MichalKot89/planar-parallel-redundant-manipulator/latex/grafika/pierwowzor_model.pdf

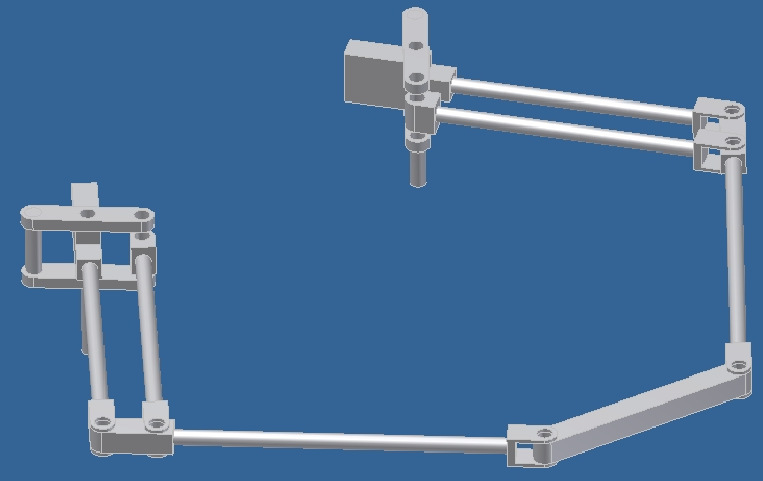
[picture p2: page 1]
