MichalKot89/planar-parallel-redundant-manipulator/latex/grafika/pierwowzor_zdjecie.pdf

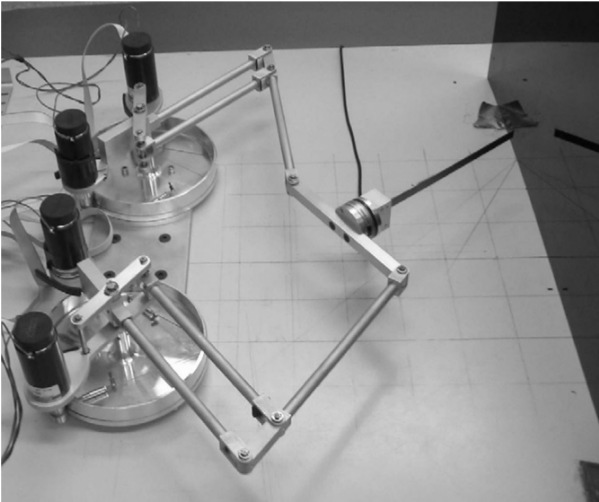
[picture p3: page 1]
