MichalKot89/planar-parallel-redundant-manipulator/Przestrzen robocza probna/Matlab/Forward/L=0.pdf

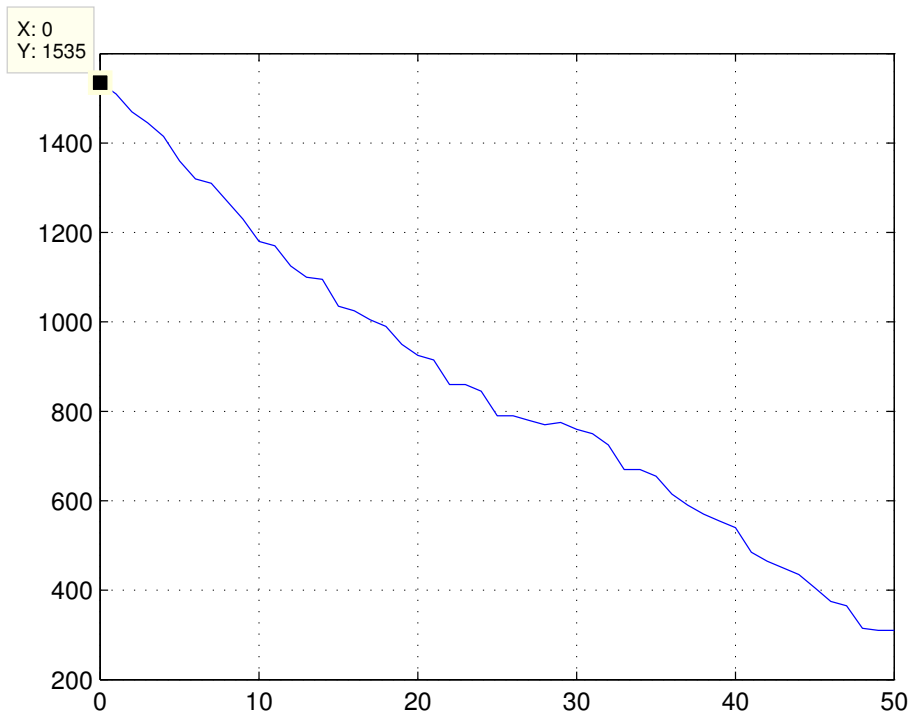
[picture p4: figure]
