MichalKot89/planar-parallel-redundant-manipulator/Przestrzen robocza probna/Matlab/Forward/L=10.pdf

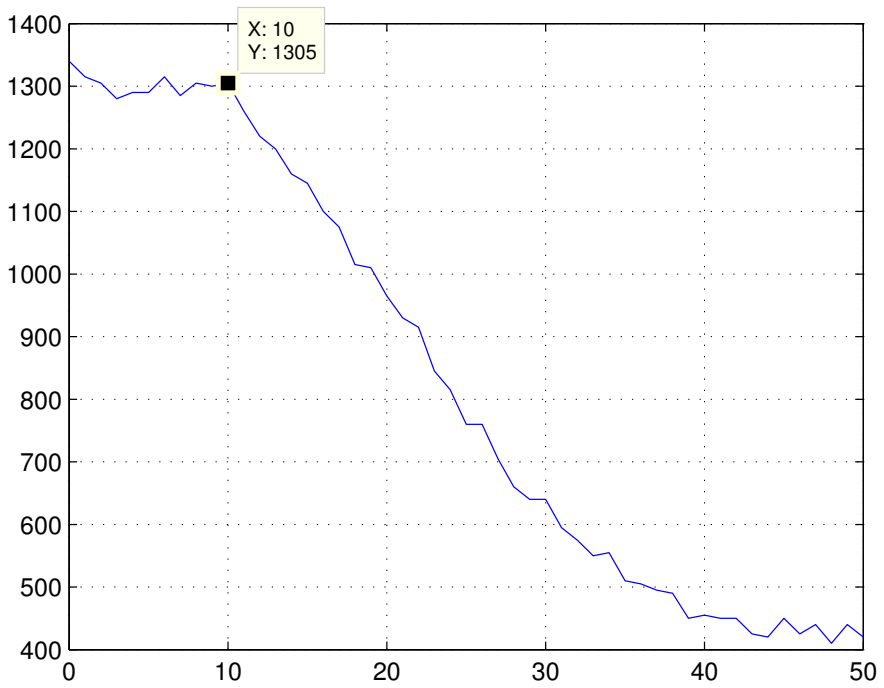
[picture p5: figure]
