MichalKot89/planar-parallel-redundant-manipulator/Przestrzen robocza probna/Matlab/Forward/L=20.pdf

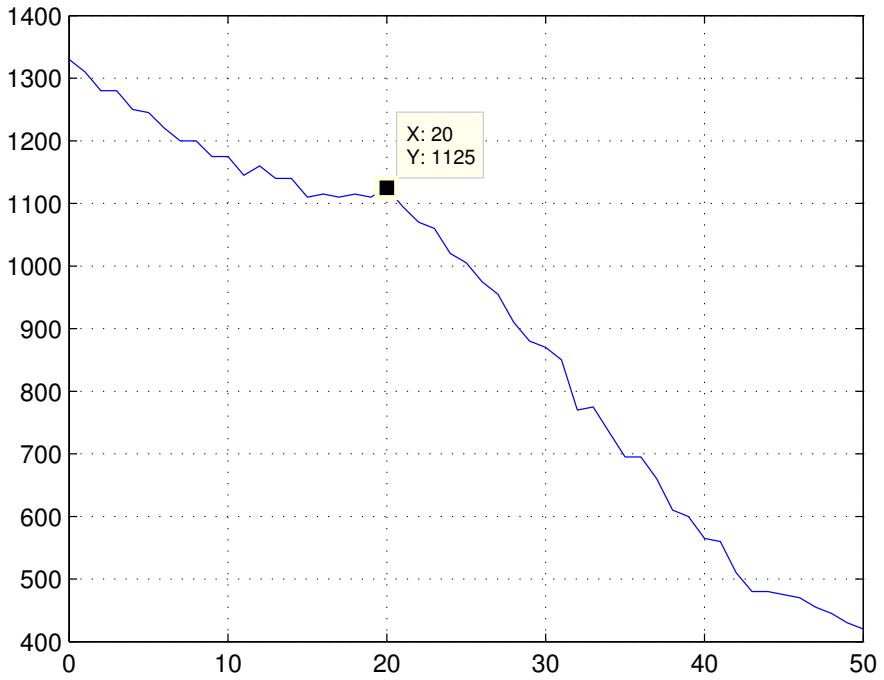
[picture p6: figure]
