MichalKot89/planar-parallel-redundant-manipulator/Przestrzen robocza probna/Matlab/Forward/L=30.pdf

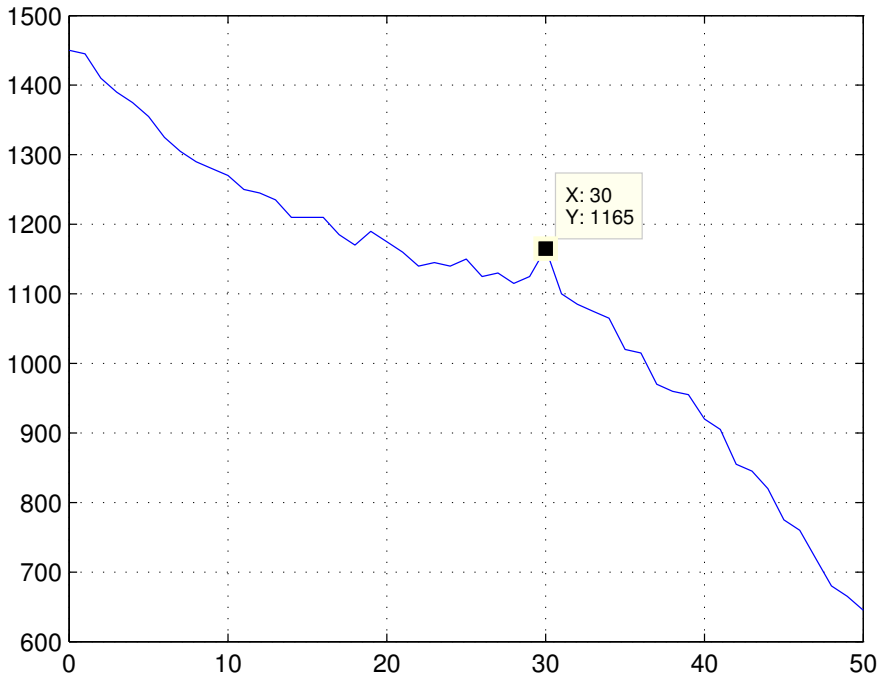
[picture p7: figure]
