MichalKot89/planar-parallel-redundant-manipulator/Przestrzen robocza probna/Matlab/Inverse/L=0_inv.pdf

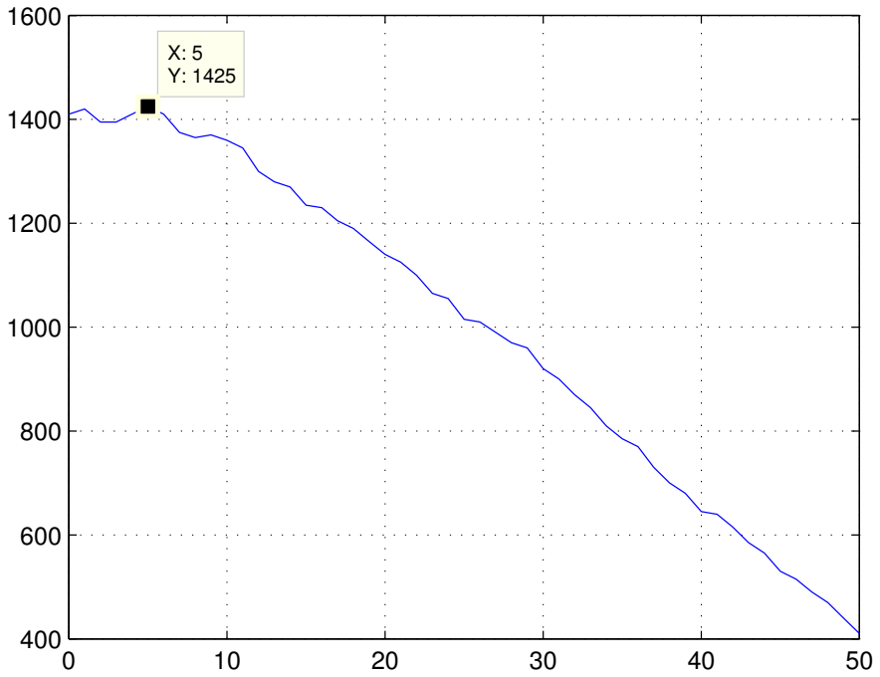
[picture p8: figure]
