MichalKot89/planar-parallel-redundant-manipulator/Przestrzen robocza probna/Matlab/Inverse/L=10_inv.pdf

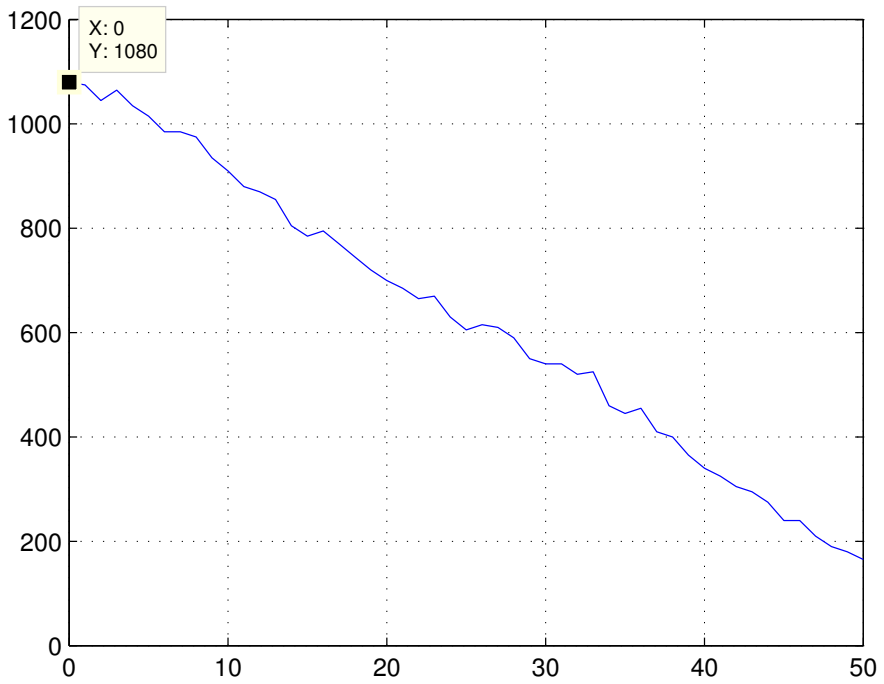
[picture p9: figure]
