MichalKot89/planar-parallel-redundant-manipulator/Przestrzen robocza probna/Matlab/Inverse/L=20_inv.pdf

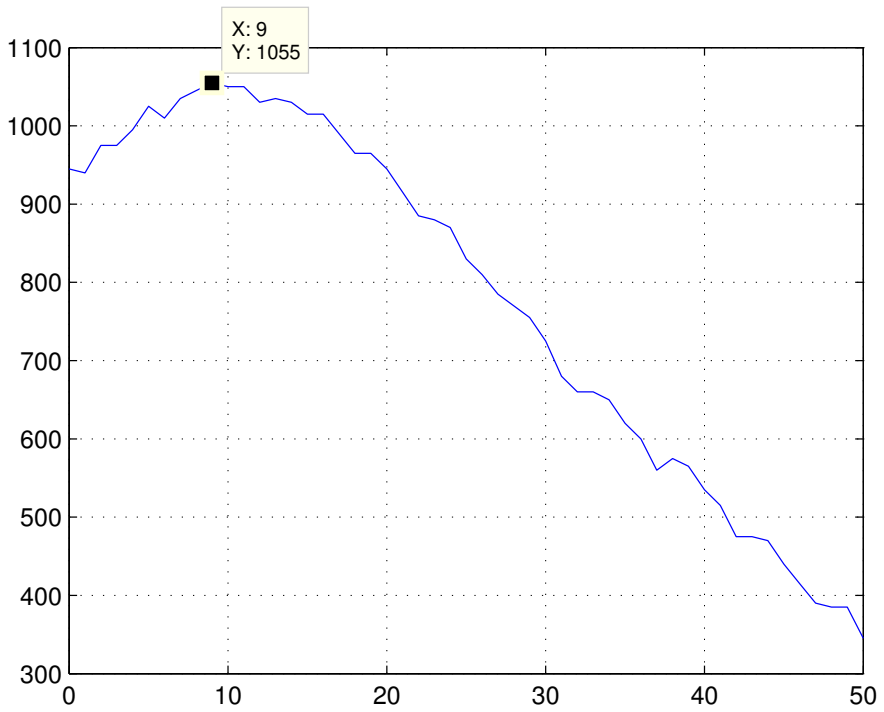
[picture p10: figure]
