MichalKot89/planar-parallel-redundant-manipulator/Przestrzen robocza probna/Matlab/Inverse/L=30_inv.pdf

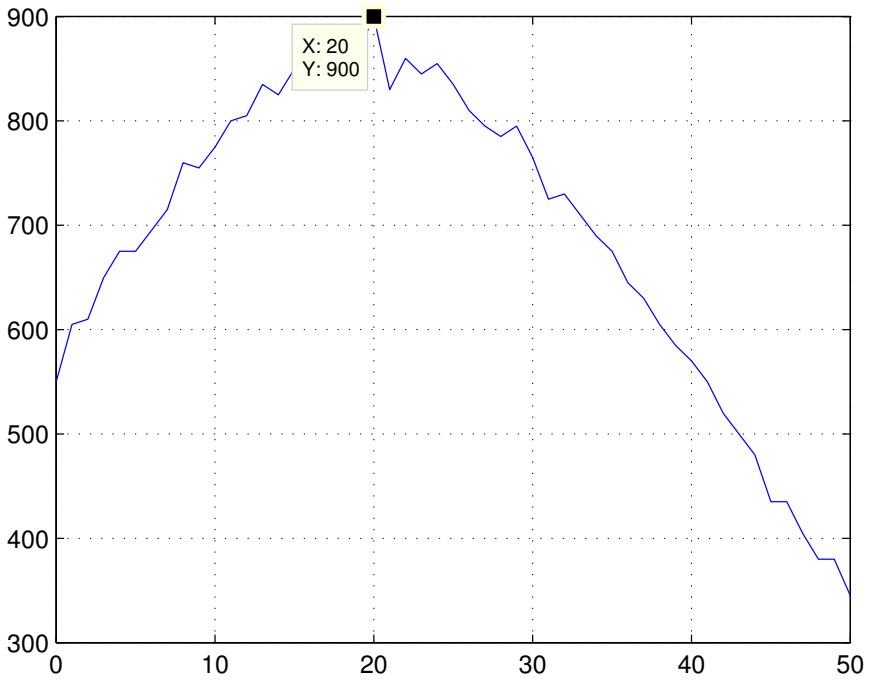
[picture p11: figure]
