MichalKot89/planar-parallel-redundant-manipulator/Przestrzen robocza probna/Matlab/Inverse/L=40_inv.pdf

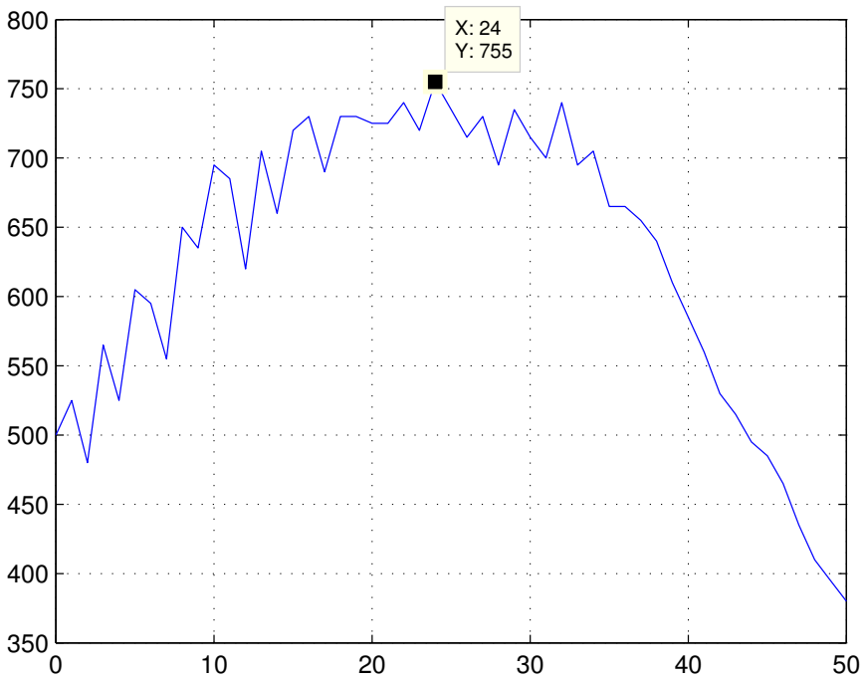
[picture p12: figure]
