MichalKot89/planar-parallel-redundant-manipulator/Praca magisterska_kopia/Inventor/lozysko1.png

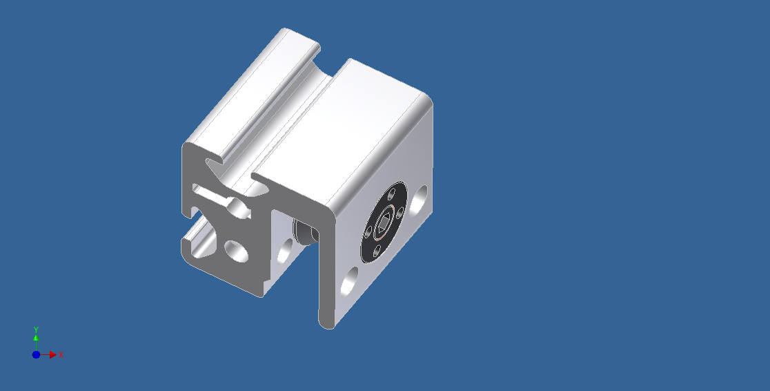
Praca magisterska_kopia/Inventor/lozysko1.png
