MichalKot89/planar-parallel-redundant-manipulator/Praca magisterska_kopia/Inventor/lozysko2.png

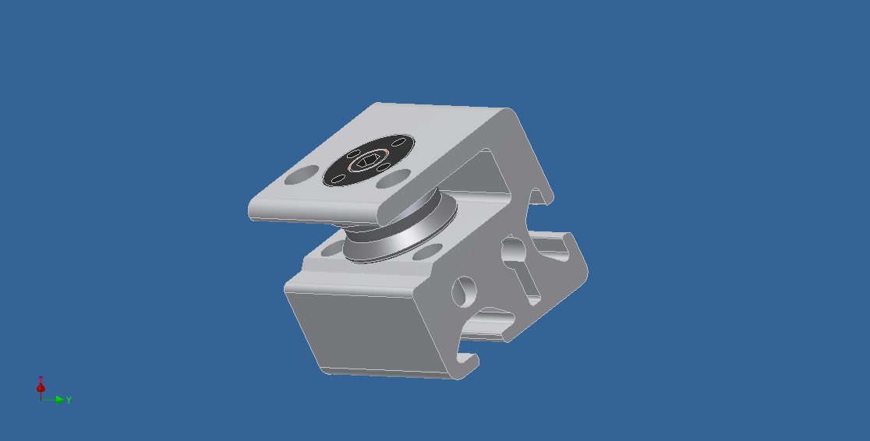
Praca magisterska_kopia/Inventor/lozysko2.png
