MichalKot89/planar-parallel-redundant-manipulator/Praca magisterska_kopia/manipulator.png

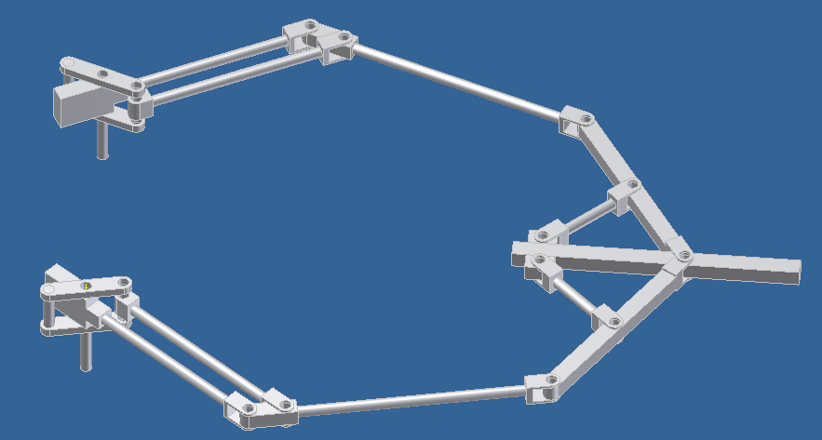
Praca magisterska_kopia/manipulator.png
