MichalKot89/planar-parallel-redundant-manipulator/(list of files, cad)

Other CAD files:
Praca magisterska_kopia/Inventor/OldVersions/item_0039016_Jednostka_o_yskowa_5_D6_e.0001.iam
Praca magisterska_kopia/Inventor/item_0035005_Jednostka_o_yskowa_8_D25_e_ocynk_.ipt
Praca magisterska_kopia/Inventor/item_0039003_Trzpie_5_D6_z_ocynk_.ipt
Praca magisterska_kopia/Inventor/item_0039016_Jednostka_o_yskowa_5_D6_e.iam
Praca magisterska_kopia/Inventor/item_0039016_Jednostka_o_yskowa_5_D6_e_1.ipt
Praca magisterska_kopia/Inventor/item_0039016_Jednostka_o_yskowa_5_D6_e_2.ipt
Praca magisterska_kopia/Inventor/item_0039016_Jednostka_o_yskowa_5_D6_e_3.ipt
Praca magisterska_kopia/Inventor/item_0039016_Jednostka_o_yskowa_5_D6_e_4.ipt
Praca magisterska_kopia/Inventor/item_0039016_Jednostka_o_yskowa_5_D6_e_5.ipt
Praca magisterska_kopia/Inventor/item_0039016_Jednostka_o_yskowa_5_D6_e_6.ipt
Praca magisterska_kopia/Inventor/item_0039016_Jednostka_o_yskowa_5_D6_e_7.ipt
