MichalKot89/planar-parallel-redundant-manipulator/(commit log)

2012-01-14 wszystko wreszcie
    [item_0035005_Jednostka_o_yskowa_8_D25_e_ocynk_.ipt, item_0039003_Trzpie_5_D6_z_ocynk_.ipt, item_0039016_Jednostka_o_yskowa_5_D6_e.0001.iam, item_0039016_Jednostka_o_yskowa_5_D6_e.iam, item_0039016_Jednostka_o_yskowa_5_D6_e_1.ipt, item_0039016_Jednostka_o_yskowa_5_D6_e_2.ipt, item_0039016_Jednostka_o_yskowa_5_D6_e_3.ipt, item_0039016_Jednostka_o_yskowa_5_D6_e_4.ipt]
2012-01-29 29.01.2012 po dopisaniu próbnych kinematyk i tensometrów
